nicolacimmino/CoreRopeMemoryBlinker/docs/pulse.png

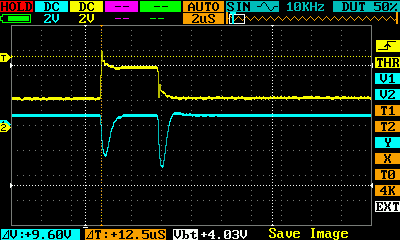
docs/pulse.png
