nicolacimmino/CoreRopeMemoryBlinker/(threads)

Thread 1 (2019-09-10):

Core rope memory

ramriot, 2019-09-10:
A small note for clarification

The circuit as described is not a correct implementation of core rope memory as used for the AGC & elsewhere because its word / core ordering it perpendicular to those implementations & it uses transformer action to carry information instead of hysteresis remanence coupling.

Apart from that its a good start.
