nicolacimmino/CoreRopeMemoryBlinker/Hardware.h

#ifndef __HARDWARE_HEADER__
#define __HARDWARE_HEADER__

#define PIN_GREEN_LED 3
#define PIN_RED_LED 12
#define PIN_COMMON_DRIVE 7
#define PIN_DRIVE_0 2
#define PIN_DRIVE_1 4
#define PIN_DRIVE_2 5
#define PIN_DRIVE_3 6
#define PIN_DRIVE_4 8
#define PIN_DRIVE_5 9
#define PIN_DRIVE_6 10
#define PIN_DRIVE_7 11
#define PIN_SENSE_0 A0
#define PIN_SENSE_1 A1
#define PIN_SENSE_2 A2
#define PIN_SENSE_3 A3

#endif
