nicolacimmino/CoreRopeMemoryBlinker/MemoryController.h

#ifndef __MEMORY_CONTROLLER_HEADER__
#define __MEMORY_CONTROLLER_HEADER__

#include <EEPROM.h>
#include "RopeMemory.h"

#define MEM_CONFIG 10
#define MEM_STATUS 11

class MemoryController
{
public:
    MemoryController();
    void begin(RopeMemory *ropeMemory);
    uint8_t read(uint8_t address);
    void write(uint8_t address, uint8_t data);
    bool isRopeMemoryOK();
    void setRopeMemoryNOK();
    bool isRopeMemoryOn();
    bool isEEPROMOn();

private:    
    RopeMemory *ropeMemory;
    uint8_t ram[48];
};

#endif
