nicolacimmino/CoreRopeMemoryBlinker/RopeBlinker.ino

//  Copyright (C) 2019 Nicola Cimmino
//
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

#include "Hardware.h"
#include "Cli.h"
#include "MemoryController.h"
#include "LEDController.h"
#include "RopeMemory.h"

Cli cli;
MemoryController memoryController;
LEDController ledController;
RopeMemory ropeMemory;

uint8_t drivePins[] = {PIN_DRIVE_0, PIN_DRIVE_1, PIN_DRIVE_2, PIN_DRIVE_3, PIN_DRIVE_4, PIN_DRIVE_5, PIN_DRIVE_6, PIN_DRIVE_7};
uint8_t sensePins[] = {PIN_SENSE_0, PIN_SENSE_1, PIN_SENSE_2, PIN_SENSE_3};

void setup()
{
    pinMode(PIN_RED_LED, OUTPUT);
    pinMode(PIN_RED_LED, OUTPUT);

    Serial.begin(115200);

    VT100.begin(Serial);

    ropeMemory.begin(PIN_COMMON_DRIVE, drivePins, sensePins);
    memoryController.begin(&ropeMemory);

    cli.begin(&Serial, &memoryController);

    ledController.begin(PIN_RED_LED, PIN_GREEN_LED, &memoryController);

    analogReference(INTERNAL);
}



void loop()
{
    cli.loop();
    ledController.loop();

    if (!memoryController.isRopeMemoryOK())
    {
        ledController.showSolidRed();
        return;
    }

    ledController.breathe();

    uint32_t value32 = 0;
    for (int address = 0; address < 4; address++)
    {
        uint8_t value = memoryController.read(address);
        value32 = (value32 << 8) | value;
    }

    if (value32 != 0xF05A4E43)
    {
        memoryController.setRopeMemoryNOK();
    }
}
