nicolacimmino/CoreRopeMemoryBlinker/(commit log)

2019-09-21 Add LED controller
2019-09-22 Add RGB strip control, add fire effect, memory map LEDController so brigthenss can be configured
